Huang-1226/syringe-bubble-compliance/analysis/data/bubble/setup_photo_clean.jpg

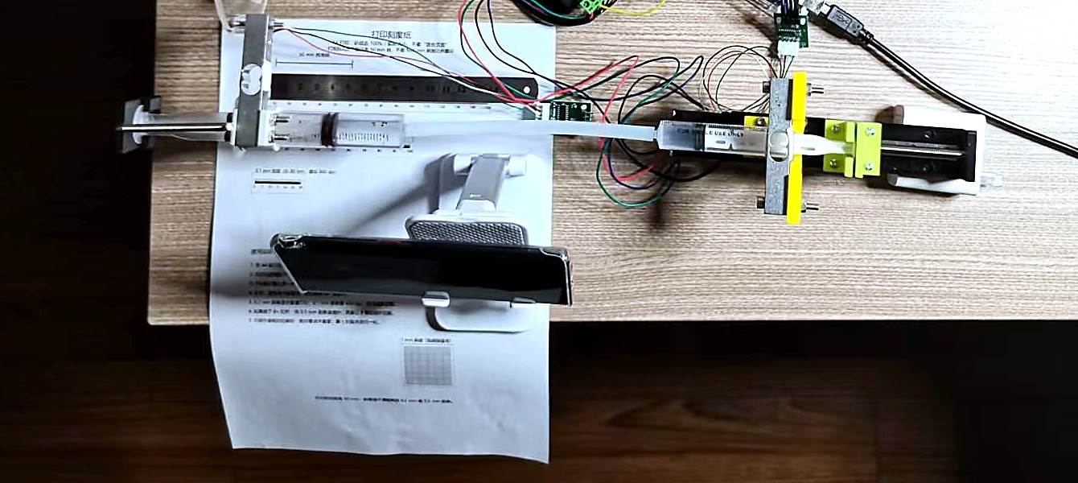
analysis/data/bubble/setup_photo_clean.jpg
