Huang-1226/syringe-bubble-compliance/hardware/stl/plunger_clip_20ml.stl

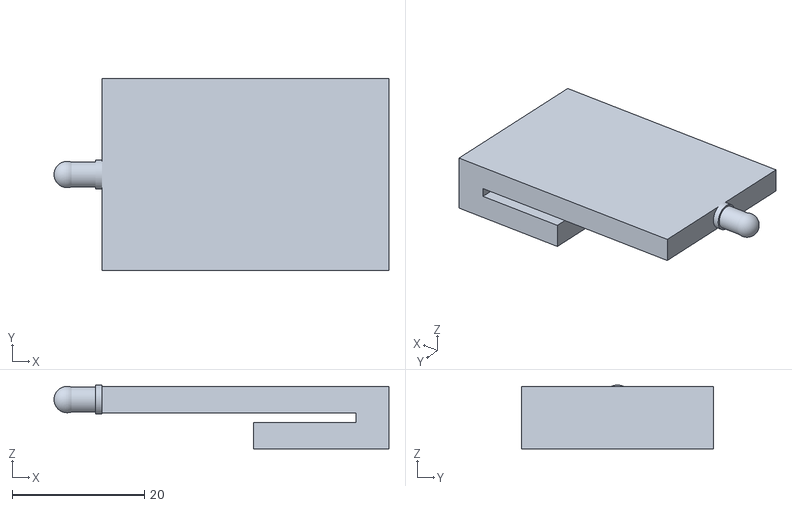
[picture p9: CAD file, 2026-10-28]
hardware/stl/plunger_clip_20ml.stl
50.7 x 29.0 x 9.68
