Huang-1226/syringe-bubble-compliance/hardware/stl/flange_clamp.stl

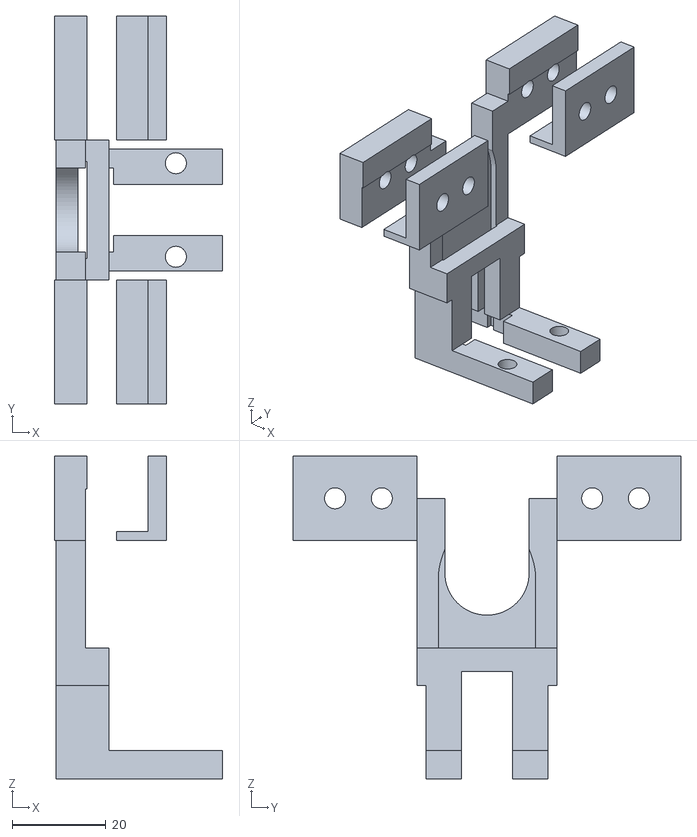
[picture p10: CAD file, 2026-10-28]
hardware/stl/flange_clamp.stl
36.0 x 83.0 x 69.0
