Huang-1226/syringe-bubble-compliance/hardware/stl/plunger_clip_10ml.stl

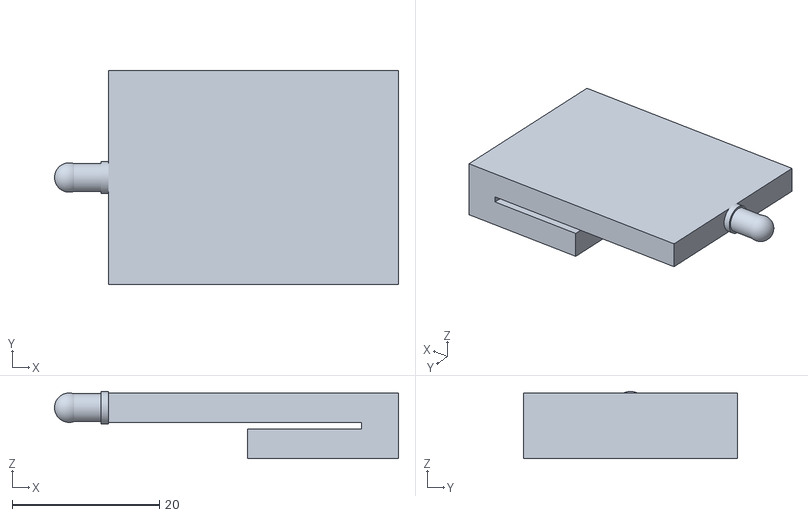
[picture p11: CAD file, 2026-10-28]
hardware/stl/plunger_clip_10ml.stl
46.7 x 29.0 x 9.10
