Huang-1226/syringe-bubble-compliance/hardware/stl/slider_coupler.stl

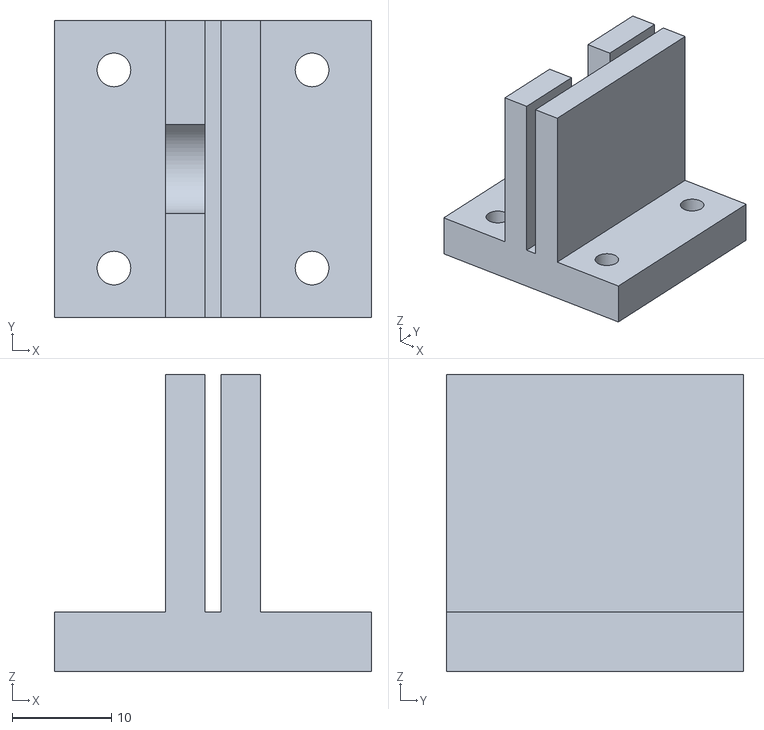
[picture p12: CAD file, 2026-10-28]
hardware/stl/slider_coupler.stl
32.0 x 30.0 x 30.0
