Huang-1226/syringe-bubble-compliance/hardware/stl/bar_hook.stl

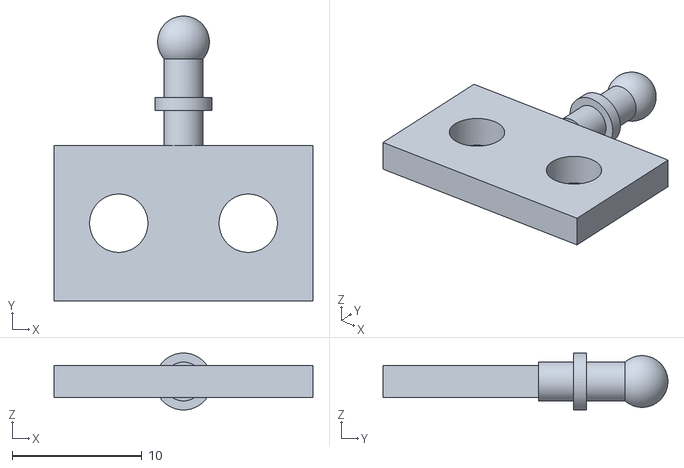
[picture p13: CAD file, 2026-10-28]
hardware/stl/bar_hook.stl
20.0 x 22.0 x 4.40
