Huang-1226/syringe-bubble-compliance/hardware/stl/plunger_clip_5ml.stl

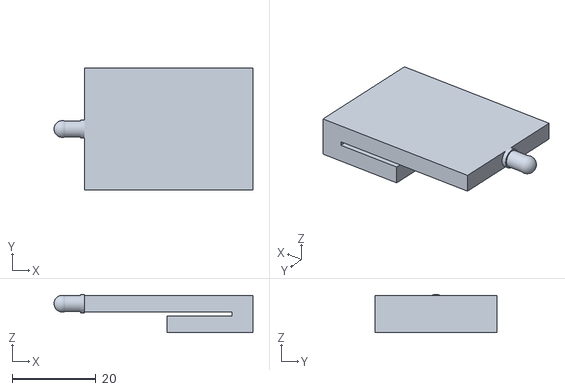
[picture p14: CAD file, 2026-10-28]
hardware/stl/plunger_clip_5ml.stl
47.5 x 29.0 x 9.10
